svenssonjoel/FMRC/README.md

# FMRC (Work in progress)
Four Motor Robot Controller.

## General videos

[FMRC: UART communication between NRF52 and STM32!](https://youtu.be/KaF7SMBezBs)

## Firmware

### STM32F4 
* Work in progress

### NRF52
* TODO Start

* PROGRAMMING NRF52 stlink:  openocd -f interface/stlink.cfg -f target/nrf52.cfg

telnet localhost 4444
 > reset 
 > program zephyr.hex verify 

# V1_0

## Hardware

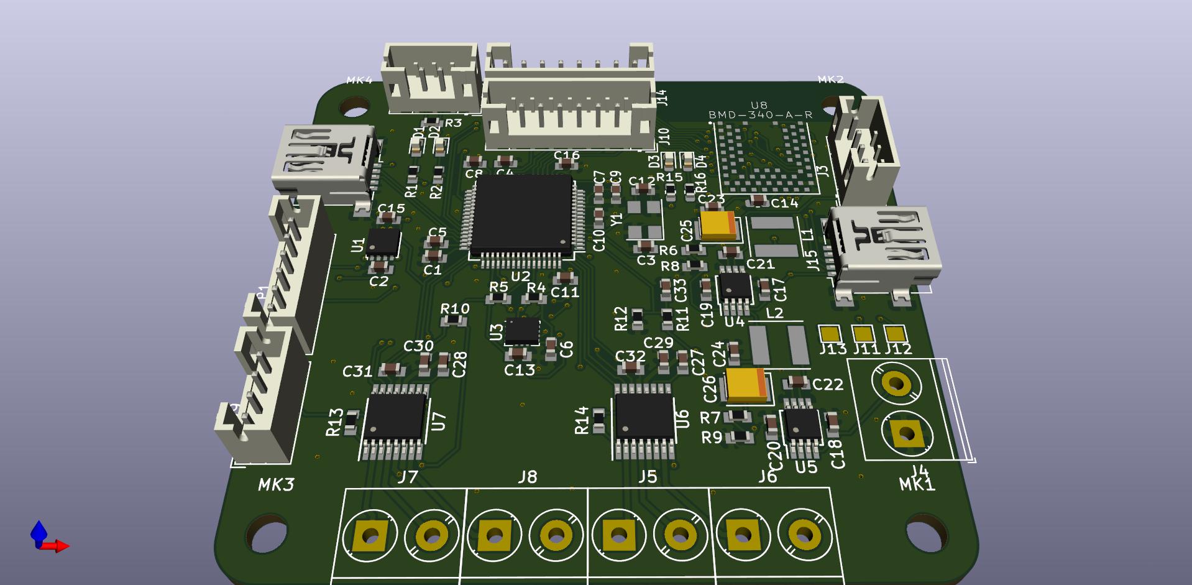
[picture p1: Pictures/FMRC_1_0.jpg]
Image of FMRC v1.0


Schematics of FMRC v1.0

whatgoeswhere FMRC v1.0

## PCBs arrived

Top view of FMRC v1.0

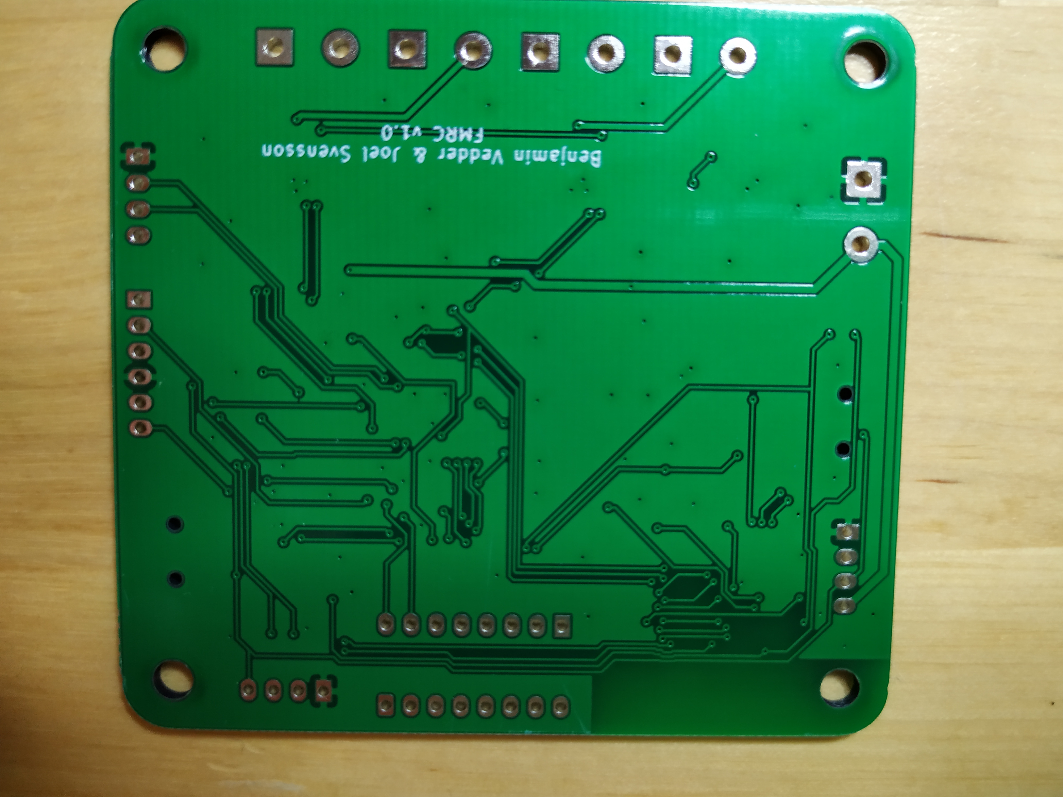
[picture p2: Pictures/bot.jpg]
Bottom view of FMRC v1.0


## Ready to start testing

Populated board FMRC v1.0

# V2_0

Work on version 2.0 is in progress. 

[FMRC V2 PART 14: First draft of completely routed PCB](https://youtu.be/DmLaImre3FM)

[FMRC V2 PART 13: More routing -- finishing off at the DRV8848 area](https://youtu.be/Vftj-5NWg6g )

[FMRC V2 PART 12: Starting to route in the DRV8848 area](https://youtu.be/RzzjTzkN7RY)

[FMRC V2 PART 11: More PCB routing](https://youtu.be/tmIGIp5ANTw)

[FMRC V2 PART 10: Started routing](https://youtu.be/_2mg14zOH1I)

[FMRC V2 PART 9: Tightening up the placement of components](https://youtu.be/uJEVWuKENiA)

[FMRC V2 PART 8: Roughly sorting components](https://youtu.be/DiCStZvnE-I)

[FMRC V2 PART 7: placing components focusing on the DC-DC area](https://youtu.be/_qIdTwvhaeo)

[FMRC V2 PART 6: Boot modes and Boot-loader that allows USB flashing](https://youtu.be/w9wKbaCBO-c)

[FMRC V2 PART 5: Adding an audio jack and doing some spice simulation in KiCAD](https://youtu.be/Df5hQqESk7Q)

[FMRC V2 PART 4: Servo outputs may be nice to have and finishing off in preparation for routing](https://youtu.be/peYSSjiu5AY)

[FMRC V2 PART 3: Out with the old, in with the new (and some confusion about pins with no net!)](https://youtu.be/iIYXo59sdyU)

[FMRC V2 PART 2B: Adding some caps and experimenting some more with kicad hierarchical labels](https://youtu.be/d1Me0BP48rM)

[FMRC V2 PART 2: Adding DRV8847 chips and trying out KICADs hiearchical labels](https://youtu.be/gP7LMV8jKK8)

[FMRC V2 PART 1: new 5V regulator that can do 3A](https://youtu.be/TqqdmnVX5Wo)
