svenssonjoel/FMRC/Pictures/whatgoeswhere.pdf

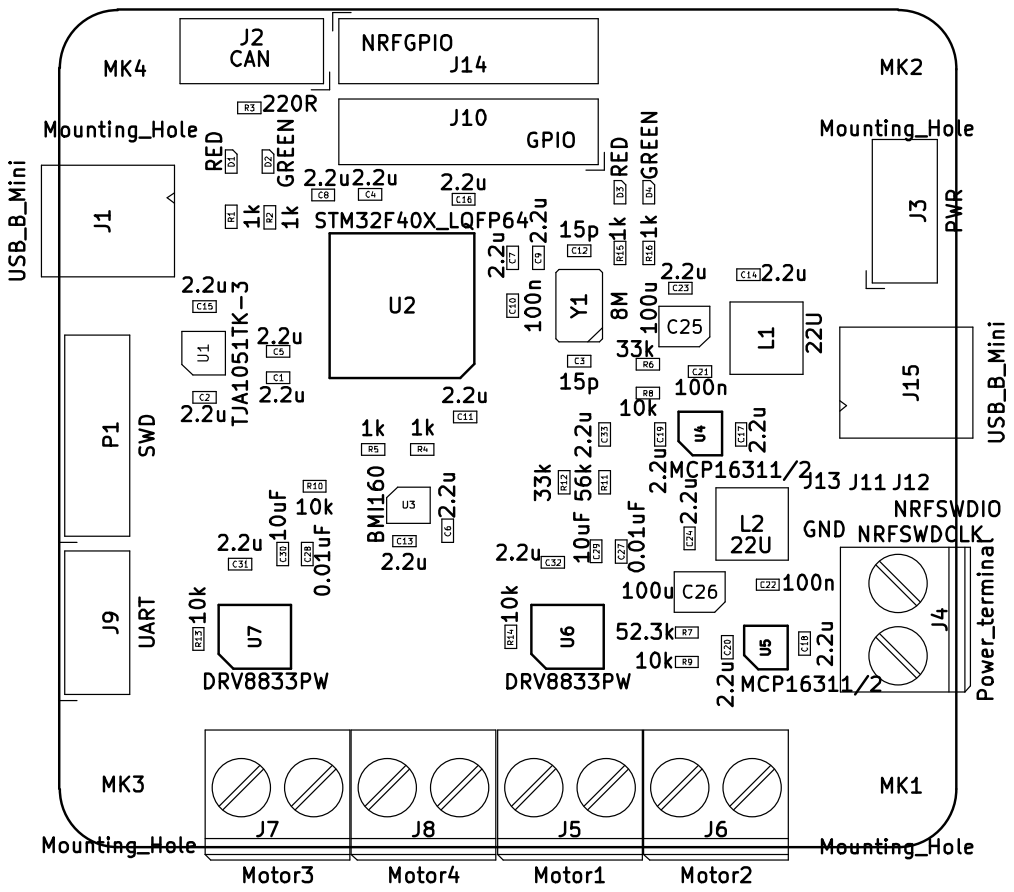
[picture p11: page 1]
