svenssonjoel/FMRC/hardware/v2_0/v2_0.kicad_pcb

## KiCad design hardware/v2_0/v2_0.kicad_pcb (2020-02-12)

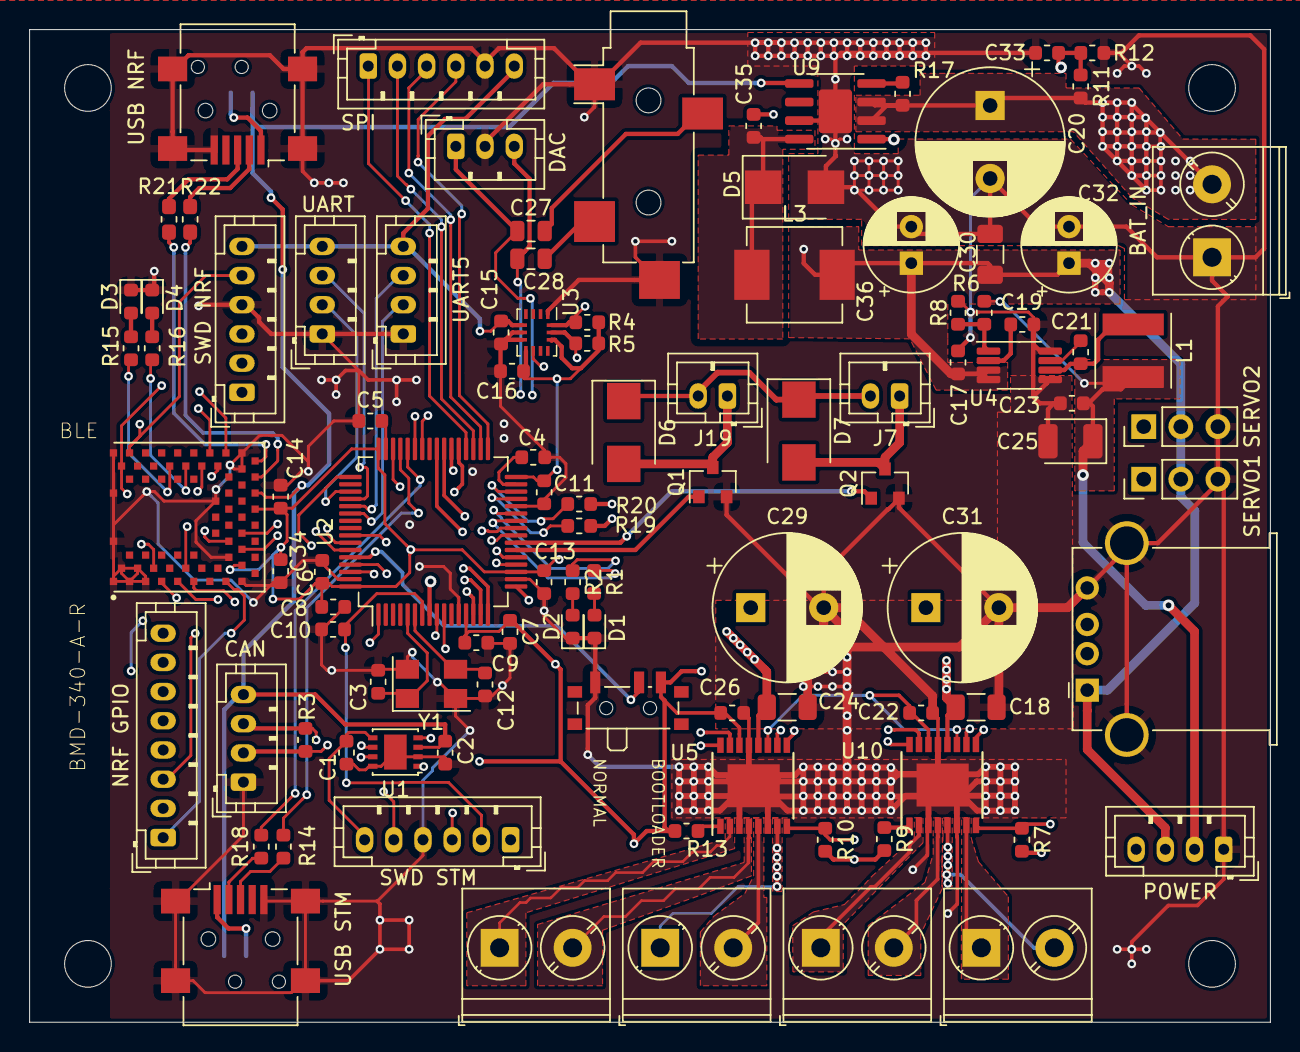
[picture p12: board v2_0.kicad_pcb from above]

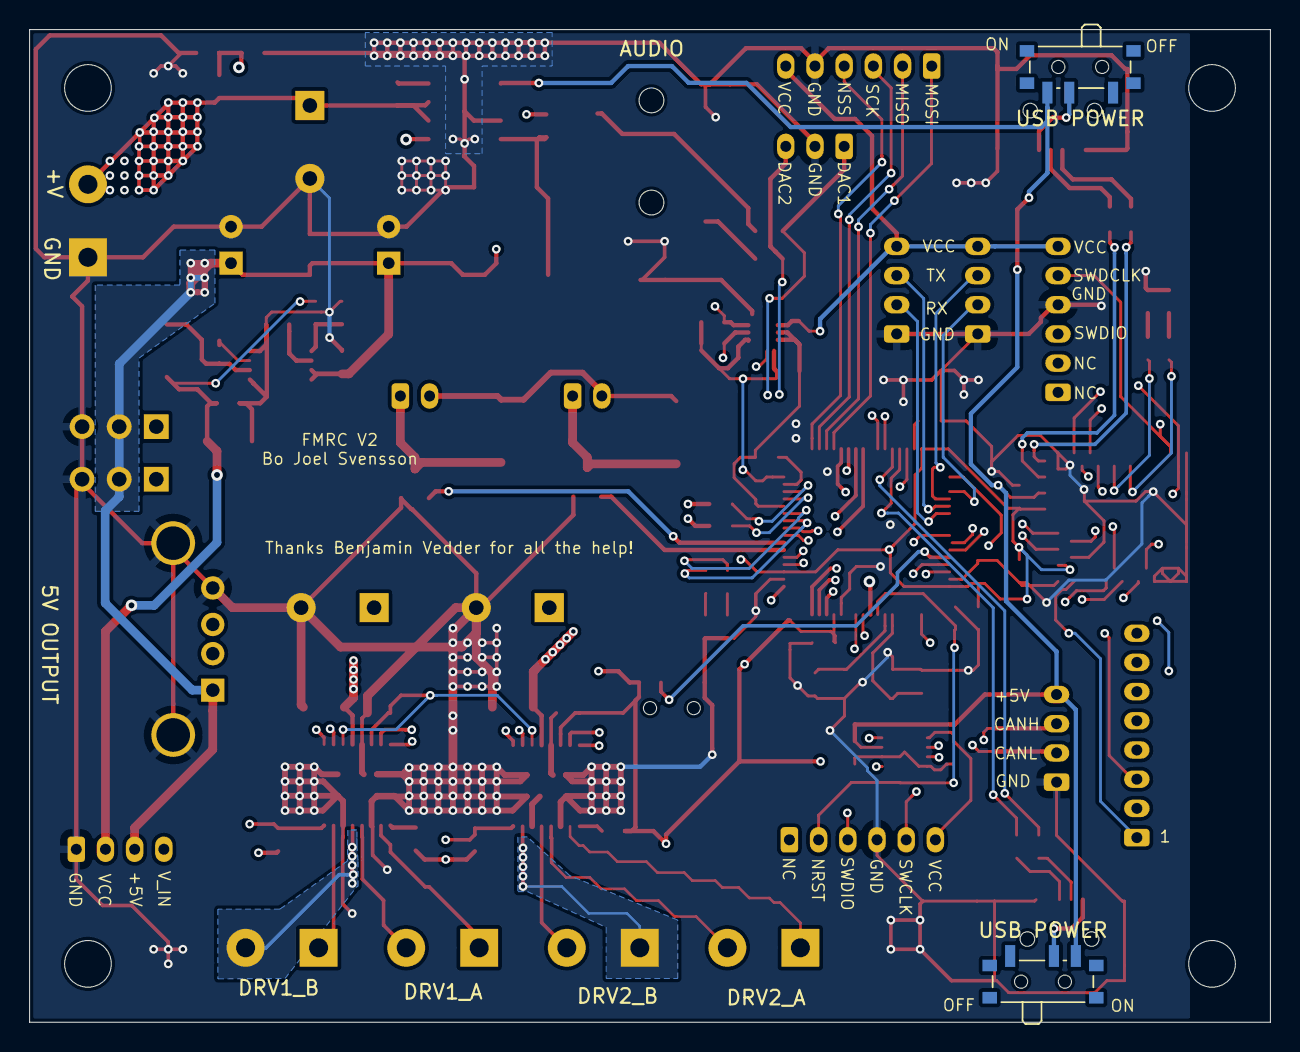
[picture p13: board v2_0.kicad_pcb from below]

Board: 4 copper layers, 85.0 x 68.0 mm, 107 parts (2 on the bottom side), 97 nets.

Parts:
5V OUTPUT: USB_A; USB_A_Stewart_SS-52100-001_Horizontal
AUDIO: AudioJack3_Ground; Jack_3.5mm_CUI_SJ-3524-SMT_Horizontal
BAT_IN: Power_terminal; TerminalBlock_Phoenix_PT-1,5-2-5.0-H_1x02_P5.00mm_Horizontal
BLE: BMD-340-A-R; RIGADO_BMD-340-A-R
C1, C2, C4, C5, C6, C7, C8, C9, C11, C13, C14, C15, C16, C17, C19, C22, C23, C26, C33, C34: 2.2u; C_0603_1608Metric
C3, C12: 15p; C_0603_1608Metric
C10, C21: 100n; C_0603_1608Metric
C18, C24, C30: 10uF; C_1206_3216Metric
C20, C29, C31: 100uF; CP_Radial_D10.0mm_P5.00mm
C25: 100u; CP_EIA-3528-12_Kemet-T
C27, C28: 10uF; C_0805_2012Metric
C32, C36: 47uF; CP_Radial_D6.3mm_P2.50mm
C35: 0.1uF; C_0603_1608Metric
CAN: CAN; JST_PH_B4B-PH-K_1x04_P2.00mm_Vertical
D1, D3: RED; LED_0603_1608Metric
D2, D4: GREEN; LED_0603_1608Metric
D5: SSB43L; D_SMB
D6, D7: D_Schottky; D_SMB
DAC: DAC; JST_PH_B3B-PH-K_1x03_P2.00mm_Vertical
DRV1_A, DRV2_A: DRV1_MTR1; TerminalBlock_Phoenix_PT-1,5-2-5.0-H_1x02_P5.00mm_Horizontal
DRV1_B, DRV2_B: DRV1_MTR2; TerminalBlock_Phoenix_PT-1,5-2-5.0-H_1x02_P5.00mm_Horizontal
J7: MTR2_CON; JST_PH_B2B-PH-K_1x02_P2.00mm_Vertical
J19: MTR1_CON; JST_PH_B2B-PH-K_1x02_P2.00mm_Vertical
L1: 22U; L_Taiyo-Yuden_MD-5050
L3: 4,7uH; L_Vishay_IHLP-2525
MK1, MK2, MK3, MK4: Mounting_Hole; MountingHole_3.2mm_M3
NRF GPIO: NRFGPIO; JST_PH_B8B-PH-K_1x08_P2.00mm_Vertical
POWER: PWR; JST_PH_B4B-PH-K_1x04_P2.00mm_Vertical
Q1, Q2: Q_NMOS_GSD; SOT-23
R1, R2, R4, R5, R15, R16: 1k; R_0603_1608Metric
R3, R19, R20: 220R; R_0603_1608Metric
R6: 33k; R_0603_1608Metric
R7, R8, R9, R10, R13: 10k; R_0603_1608Metric
R11: 56k; R_0603_1608Metric
R12: 12k; R_0603_1608Metric
R14, R18: 22R; R_0603_1608Metric
R17: 100k; R_0603_1608Metric
R21, R22: 22R; R_0603_1608Metric_Pad1.05x0.95mm_HandSolder
SERVO1: SERV1; PinHeader_1x03_P2.54mm_Vertical
SERVO2: SERV2; PinHeader_1x03_P2.54mm_Vertical
SPI: SPI; JST_PH_B6B-PH-K_1x06_P2.00mm_Vertical
SW3: BOOT0; SW_SPDT_PCM12
SWD NRF: NRFSWD; JST_PH_B6B-PH-K_1x06_P2.00mm_Vertical
SWD STM: SWD; JST_PH_B6B-PH-K_1x06_P2.00mm_Vertical
U1: TJA1051TK-3; DFN-8-1EP_3x3mm_P0.65mm_EP1.55x2.4mm
U2: STM32F40X_LQFP64; LQFP-64_10x10mm_P0.5mm
U3: BMI160; Bosch_LGA-14_3x2.5mm_P0.5mm
U4: MCP16311/2; MSOP-8_3x3mm_P0.65mm
U5, U10: DRV8848; TSSOP-16-1EP_4.4x5mm_P0.65mm
U9: ADP2303ARDZ-5.0; SOIC-8-1EP_3.9x4.9mm_P1.27mm_EP2.29x3mm
UART: USART3_UART4; JST_PH_B4B-PH-K_1x04_P2.00mm_Vertical
UART5: UART5; JST_PH_B4B-PH-K_1x04_P2.00mm_Vertical
USB NRF: USB_B_Mini; USB_Mini-B_Lumberg_2486_01_Horizontal
USB POWER: NRF_USB_POWER; SW_SPDT_PCM12
USB POWER#2: MCU_USB_POWER; SW_SPDT_PCM12
USB STM: USB_B_Mini; USB_Mini-B_Lumberg_2486_01_Horizontal
Y1: 8M; Crystal_SMD_5032-4Pin_5.0x3.2mm

Connections:
+5V: 5V OUTPUT.1, BLE.66, C2.1, C17.1, C30.1, C32.1, C36.1, CAN.4, L3.2, POWER.3, SERVO1.2, SERVO2.2, U1.3, U4.3, U4.4, U9.5, USB POWER.3, USB POWER#2.3
/DRV1_A1: U2.14, U10.16
/DRV1_A2: U2.15, U10.15
/DRV1_B1: U2.16, U10.9
/DRV1_B2: U2.17, U10.10
/DRV1_NFAULT: R7.1, U2.24, U10.8
/DRV2_A1: U2.37, U5.16
/DRV2_A2: U2.38, U5.15
/DRV2_B1: U2.39, U5.9
/DRV2_B2: U2.40, U5.10
/MTR1_PWM: Q1.1, U2.22
/MTR2_PWM: Q2.1, U2.23
/NFAULT_DRV2: R10.1, U2.25, U5.8
/base_sheet/BOOT0: SW3.2, U2.60
/base_sheet/SERV1: R19.1, U2.29
/base_sheet/SERV2: R20.1, U2.30
/base_sheet/SPI2_MISO: SPI.2, U2.35
/base_sheet/SPI2_MOSI: SPI.1, U2.36
/base_sheet/SPI2_NSS: SPI.4, U2.33
/base_sheet/SPI2_SCK: SPI.3, U2.34
/base_sheet/UART5_RX: U2.54, UART5.2
/base_sheet/UART5_TX: U2.53, UART5.3
CANH: CAN.3, R3.2, U1.7
CANL: CAN.2, R3.1, U1.6
CAN_RX: U1.4, U2.61
CAN_TX: U1.1, U2.62
GND: 5V OUTPUT.4, 5V OUTPUT.5, AUDIO.G, AUDIO.S, BAT_IN.1, BLE.1, BLE.2, BLE.3, BLE.4, BLE.5, BLE.16, BLE.18, BLE.29, BLE.30, BLE.45, BLE.46, BLE.47, BLE.55, C1.2, C2.2, C3.1, C4.1, C5.1, C6.2, C7.2, C8.2, C9.2, C10.2, C11.2, C12.1, C13.2, C14.2, C15.2, C16.2, C17.2, C18.1, C19.2, C20.2, C22.2, C23.2, C24.1, C25.2, C26.2, C29.2, C30.2, C31.2, C32.2, C33.1, C34.2, C36.2, CAN.1, D1.1, D2.1, D3.1, D4.1, D5.2, DAC.2, POWER.1, Q1.2, Q2.2, R8.1, R12.2, SERVO1.3, SERVO2.3, SPI.5, SW3.1, SWD NRF.4, SWD STM.4, U1.2, U1.8, U1.9, U2.12, U2.18, U2.28, U2.63, U3.1, U3.6, U3.7, U4.5, U4.8, U5.3, U5.6, U5.13, U5.17, U9.7, U9.9, U10.3, U10.6, U10.13, U10.17, UART.1, UART5.1, USB NRF.5, USB NRF.6, USB STM.5, USB STM.6, Y1.2, Y1.4
IMU_INT2: BLE.11, U2.57, U3.9
NRFGPIO1: BLE.15, NRF GPIO.1
NRFGPIO2: BLE.19, NRF GPIO.2
NRFGPIO3: BLE.20, NRF GPIO.3
NRFGPIO4: BLE.21, NRF GPIO.4
NRFGPIO5: BLE.31, NRF GPIO.5
NRFGPIO6: BLE.32, NRF GPIO.6
NRFGPIO7: BLE.33, NRF GPIO.7
NRFGPIO8: BLE.34, NRF GPIO.8
NRFRX: BLE.7, U2.42
NRFSWDCLK: BLE.43, SWD NRF.5, U2.10
NRFSWDIO: BLE.44, SWD NRF.3, U2.9
NRFTX: BLE.6, U2.43
NRFUSBD+: BLE.68, R21.2
NRFUSBD-: BLE.67, R22.2
NRST: C10.1, SWD STM.2, U2.7
unnamed: C3.2, U2.5, Y1.1
unnamed: C4.2, U2.31
unnamed: C5.2, U2.47
unnamed: C12.2, U2.6, Y1.3
unnamed: C19.1, U4.2
unnamed: C21.1, U4.7
unnamed: C21.2, L1.1, U4.6
unnamed: C27.1, DAC.1, U2.20
unnamed: AUDIO.R, C27.2
unnamed: C28.1, DAC.3, U2.21
unnamed: AUDIO.T, C28.2
unnamed: C35.1, U9.1
unnamed: C35.2, D5.1, L3.1, U9.8
unnamed: D1.2, R1.2
unnamed: D2.2, R2.2
unnamed: D3.2, R15.2
unnamed: D4.2, R16.2
unnamed: D6.2, J19.1, Q1.3
unnamed: D7.2, J7.1, Q2.3
unnamed: USB POWER#2.2, USB STM.1
unnamed: R18.1, USB STM.2
unnamed: R14.1, USB STM.3
unnamed: DRV1_A.1, U10.2
unnamed: DRV1_A.2, U10.4
unnamed: DRV1_B.1, U10.7
unnamed: DRV1_B.2, U10.5
unnamed: DRV2_A.1, U5.2
unnamed: DRV2_A.2, U5.4
unnamed: R19.2, SERVO1.1
unnamed: R20.2, SERVO2.1
unnamed: USB NRF.1, USB POWER.2
unnamed: R22.1, USB NRF.2
unnamed: R21.1, USB NRF.3
unnamed: DRV2_B.1, U5.7
unnamed: DRV2_B.2, U5.5
unnamed: R1.1, U2.26
unnamed: R2.1, U2.27
unnamed: R6.1, R8.2, U4.1
unnamed: R9.1, U10.1
unnamed: R13.1, U5.1
unnamed: BLE.38, R15.1
unnamed: BLE.36, R16.1
unnamed: R17.2, U9.4
SCL: BLE.10, R5.1, U2.58, U3.13
SDA: BLE.9, R4.1, U2.59, U3.14
SWCLK: SWD STM.5, U2.49
SWDIO: SWD STM.3, U2.46
UART_RXD: U2.51, UART.2
UART_TXD: U2.52, UART.3
USB_DM: R18.2, U2.44
USB_DP: R14.2, U2.45
VCC: BLE.17, BLE.65, C1.1, C6.1, C7.1, C8.1, C9.1, C11.1, C13.1, C14.1, C15.1, C16.1, C22.1, C23.1, C25.1, C26.1, C34.1, L1.2, POWER.2, R4.2, R5.2, R6.2, R7.2, R9.2, R10.2, R13.2, SPI.6, SW3.3, SWD NRF.6, SWD STM.6, U1.5, U2.1, U2.13, U2.19, U2.32, U2.48, U2.64, U3.5, U3.8, U3.12, U5.11, U5.14, U10.11, U10.14, UART.4, UART5.4
V_IN: BAT_IN.2, C18.2, C20.1, C24.2, C29.1, C31.1, D6.1, D7.1, J7.2, J19.2, POWER.4, R11.2, R17.1, U5.12, U9.2, U9.3, U10.12
V_METER: C33.2, R11.1, R12.1, U2.8
