svenssonjoel/FMRC/hardware/v1_0/robot_pcb0.kicad_pcb

## KiCad design hardware/v1_0/robot_pcb0.kicad_pcb (2019-06-18, an earlier design)

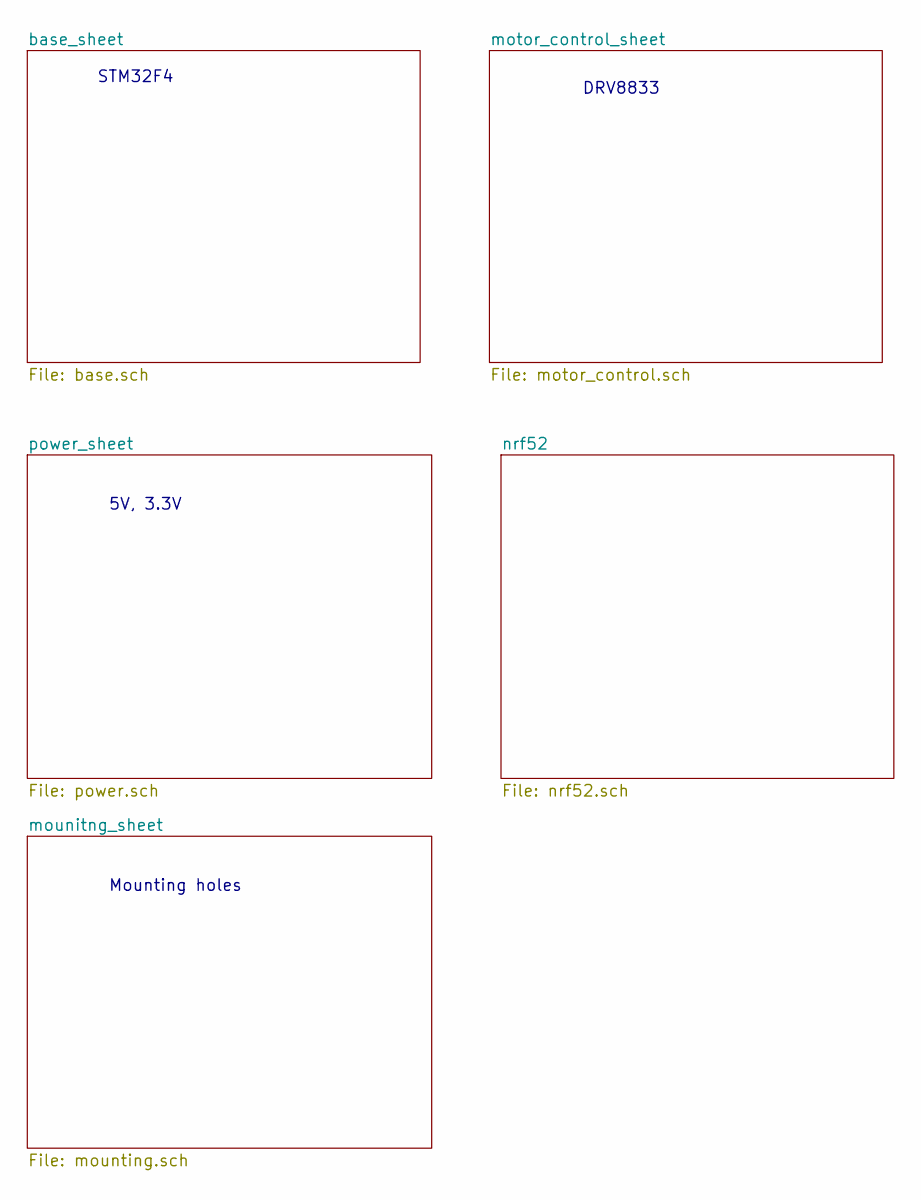
[picture p14: schematic robot_pcb0.sch, Four DC-Motor Controller]

Notes on the sheet:
STM32F4
5V, 3.3V
Mounting holes
DRV8833

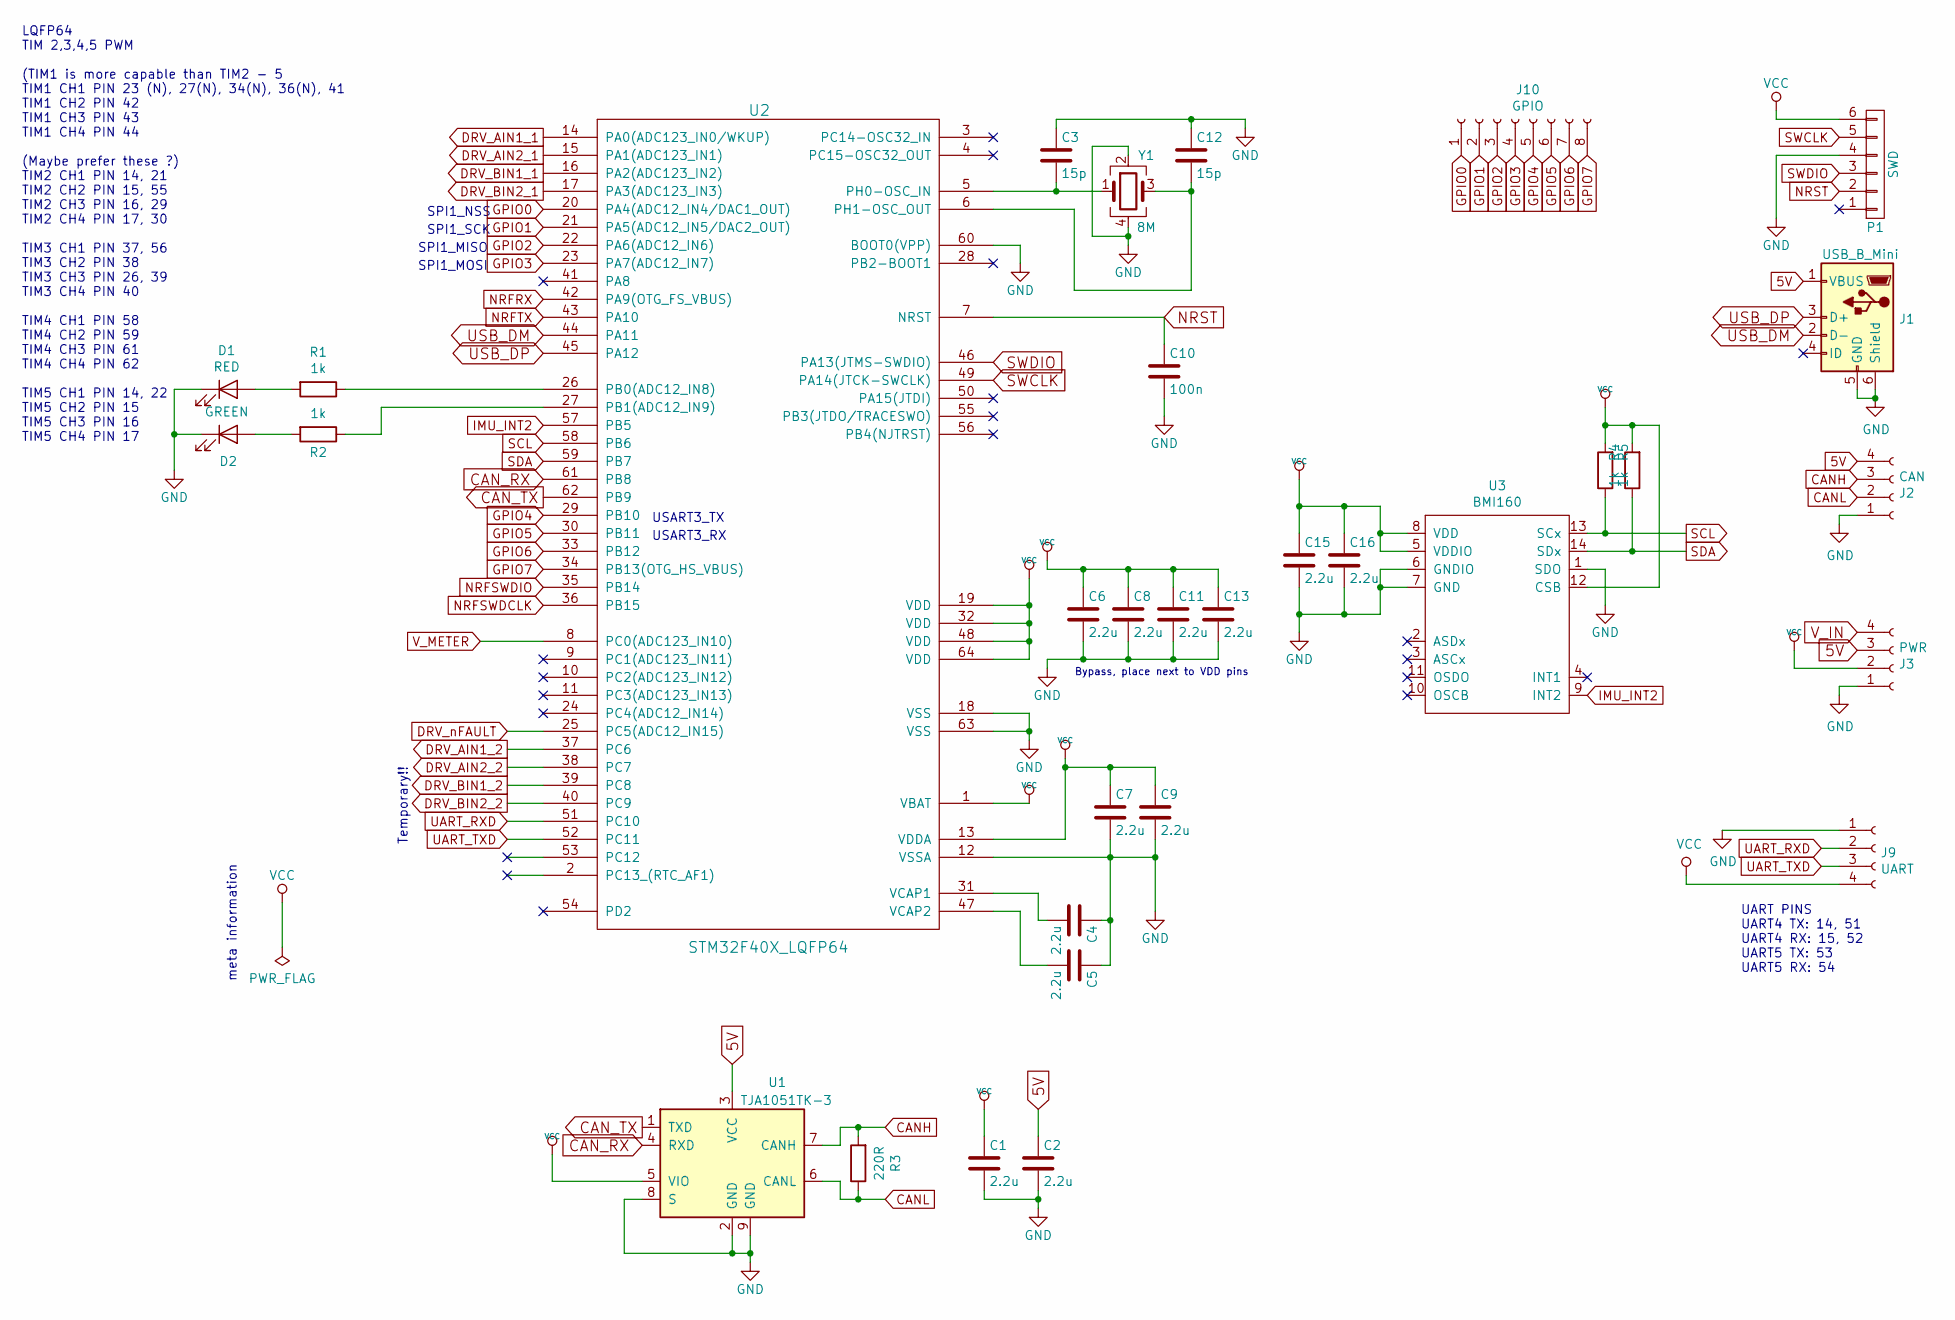
[picture p15: schematic base.sch]

Parts:
C1, C2, C4, C5, C6, C7, C8, C9, C11, C13, C15, C16: 2.2u; C_0603_1608Metric
C3, C12: 15p; C_0603_1608Metric
C10: 100n; C_0603_1608Metric
D1: RED; LED_0603_1608Metric
D2: GREEN; LED_0603_1608Metric
J1: USB_B_Mini; USB_Mini-B_Lumberg_2486_01_Horizontal
J2: CAN; JST_PH_B4B-PH-K_1x04_P2.00mm_Vertical
J3: PWR; JST_PH_B4B-PH-K_1x04_P2.00mm_Vertical
J9: UART; JST_PH_B4B-PH-K_1x04_P2.00mm_Vertical
J10: GPIO; JST_PH_B8B-PH-K_1x08_P2.00mm_Vertical
P1: SWD; JST_PH_B6B-PH-K_1x06_P2.00mm_Vertical
R1, R2, R4, R5: 1k; R_0603_1608Metric
R3: 220R; R_0603_1608Metric
U1: TJA1051TK-3; DFN-8-1EP_3x3mm_P0.65mm_EP1.55x2.4mm
U2: STM32F40X_LQFP64; LQFP-64_10x10mm_P0.5mm
U3: BMI160; Bosch_LGA-14_3x2.5mm_P0.5mm
Y1: 8M; Crystal_SMD_5032-4Pin_5.0x3.2mm

Connections:
5V: C2.1, J1.1 (VBUS), J2.4, J3.3, U1.3 (VCC); also elsewhere on the board
CANH: J2.3, R3.2, U1.7 (CANH)
CANL: J2.2, R3.1, U1.6 (CANL)
CAN_RX: U1.4 (RXD), U2.61 (PB8)
CAN_TX: U1.1 (TXD), U2.62 (PB9)
DRV_AIN1_1: U2.14 (PA0(ADC123_IN0/WKUP)); also elsewhere on the board
DRV_AIN1_2: U2.37 (PC6); also elsewhere on the board
DRV_AIN2_1: U2.15 (PA1(ADC123_IN1)); also elsewhere on the board
DRV_AIN2_2: U2.38 (PC7); also elsewhere on the board
DRV_BIN1_1: U2.16 (PA2(ADC123_IN2)); also elsewhere on the board
DRV_BIN1_2: U2.39 (PC8); also elsewhere on the board
DRV_BIN2_1: U2.17 (PA3(ADC123_IN3)); also elsewhere on the board
DRV_BIN2_2: U2.40 (PC9); also elsewhere on the board
DRV_nFAULT: U2.25 (PC5(ADC12_IN15)); also elsewhere on the board
GND: C1.2, C2.2, C3.1, C4.1, C5.1, C6.2, C7.2, C8.2, C9.2, C10.2, C11.2, C12.1, C13.2, C15.2, C16.2, D1.1 (K), D2.1 (K), J1.5 (GND), J1.6 (Shield), J2.1, J3.1, J9.1, P1.4, U1.2 (GND), U1.8 (S), U1.9 (GND), U2.12 (VSSA), U2.18 (VSS), U2.60 (BOOT0(VPP)), U2.63 (VSS), U3.1 (SDO), U3.6 (GNDIO), U3.7 (GND), Y1.2, Y1.4; also elsewhere on the board
GPIO0: J10.1, U2.20 (PA4(ADC12_IN4/DAC1_OUT))
GPIO1: J10.2, U2.21 (PA5(ADC12_IN5/DAC2_OUT))
GPIO2: J10.3, U2.22 (PA6(ADC12_IN6))
GPIO3: J10.4, U2.23 (PA7(ADC12_IN7))
GPIO4: J10.5, U2.29 (PB10)
GPIO5: J10.6, U2.30 (PB11)
GPIO6: J10.7, U2.33 (PB12)
GPIO7: J10.8, U2.34 (PB13(OTG_HS_VBUS))
IMU_INT2: U2.57 (PB5), U3.9 (INT2); also elsewhere on the board
NRFRX: U2.42 (PA9(OTG_FS_VBUS)); also elsewhere on the board
NRFSWDCLK: U2.36 (PB15); also elsewhere on the board
NRFSWDIO: U2.35 (PB14); also elsewhere on the board
NRFTX: U2.43 (PA10); also elsewhere on the board
NRST: C10.1, P1.2, U2.7 (NRST)
unnamed: C3.2, U2.5 (PH0-OSC_IN), Y1.1
unnamed: C4.2, U2.31 (VCAP1)
unnamed: C5.2, U2.47 (VCAP2)
unnamed: C12.2, U2.6 (PH1-OSC_OUT), Y1.3
unnamed: D1.2 (A), R1.2
unnamed: D2.2 (A), R2.2
unnamed: R1.1, U2.26 (PB0(ADC12_IN8))
unnamed: R2.1, U2.27 (PB1(ADC12_IN9))
SCL: R5.1, U2.58 (PB6), U3.13 (SCx); also elsewhere on the board
SDA: R4.1, U2.59 (PB7), U3.14 (SDx); also elsewhere on the board
SWCLK: P1.5, U2.49 (PA14(JTCK-SWCLK))
SWDIO: P1.3, U2.46 (PA13(JTMS-SWDIO))
UART_RXD: J9.2, U2.51 (PC10)
UART_TXD: J9.3, U2.52 (PC11)
USB_DM: J1.2 (D-), U2.44 (PA11)
USB_DP: J1.3 (D+), U2.45 (PA12)
VCC: C1.1, C6.1, C7.1, C8.1, C9.1, C11.1, C13.1, C15.1, C16.1, J3.2, J9.4, P1.6, R4.2, R5.2, U1.5 (VIO), U2.1 (VBAT), U2.13 (VDDA), U2.19 (VDD), U2.32 (VDD), U2.48 (VDD), U2.64 (VDD), U3.5 (VDDIO), U3.8 (VDD), U3.12 (CSB); also elsewhere on the board
V_IN: J3.4; also elsewhere on the board
V_METER: U2.8 (PC0(ADC123_IN10)); also elsewhere on the board

Notes on the sheet:
Bypass, place next to VDD pins
meta information
Temporary!!
UART PINS UART4 TX: 14, 51 UART4 RX: 15, 52 UART5 TX: 53 UART5 RX: 54
USART3_TX
USART3_RX
SPI1_NSS
SPI1_SCK
SPI1_MISO
SPI1_MOSI
LQFP64 TIM 2,3,4,5 PWM (TIM1 is more capable than TIM2 - 5 TIM1 CH1 PIN 23 (N), 27(N), 34(N), 36(N), 41 TIM1 CH2 PIN 42 TIM1 CH3 PIN 43 TIM1 CH4 PIN 44 (Maybe prefer these ?) TIM2 CH1 PIN 14, 21 TIM2 CH2 PIN 15, 55 TIM2 CH3 PIN 16, 29 TIM2 CH4 PIN 17, 30 TIM3 CH1 PIN 37, 56 TIM3 CH2 PIN 38 TIM3 CH3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

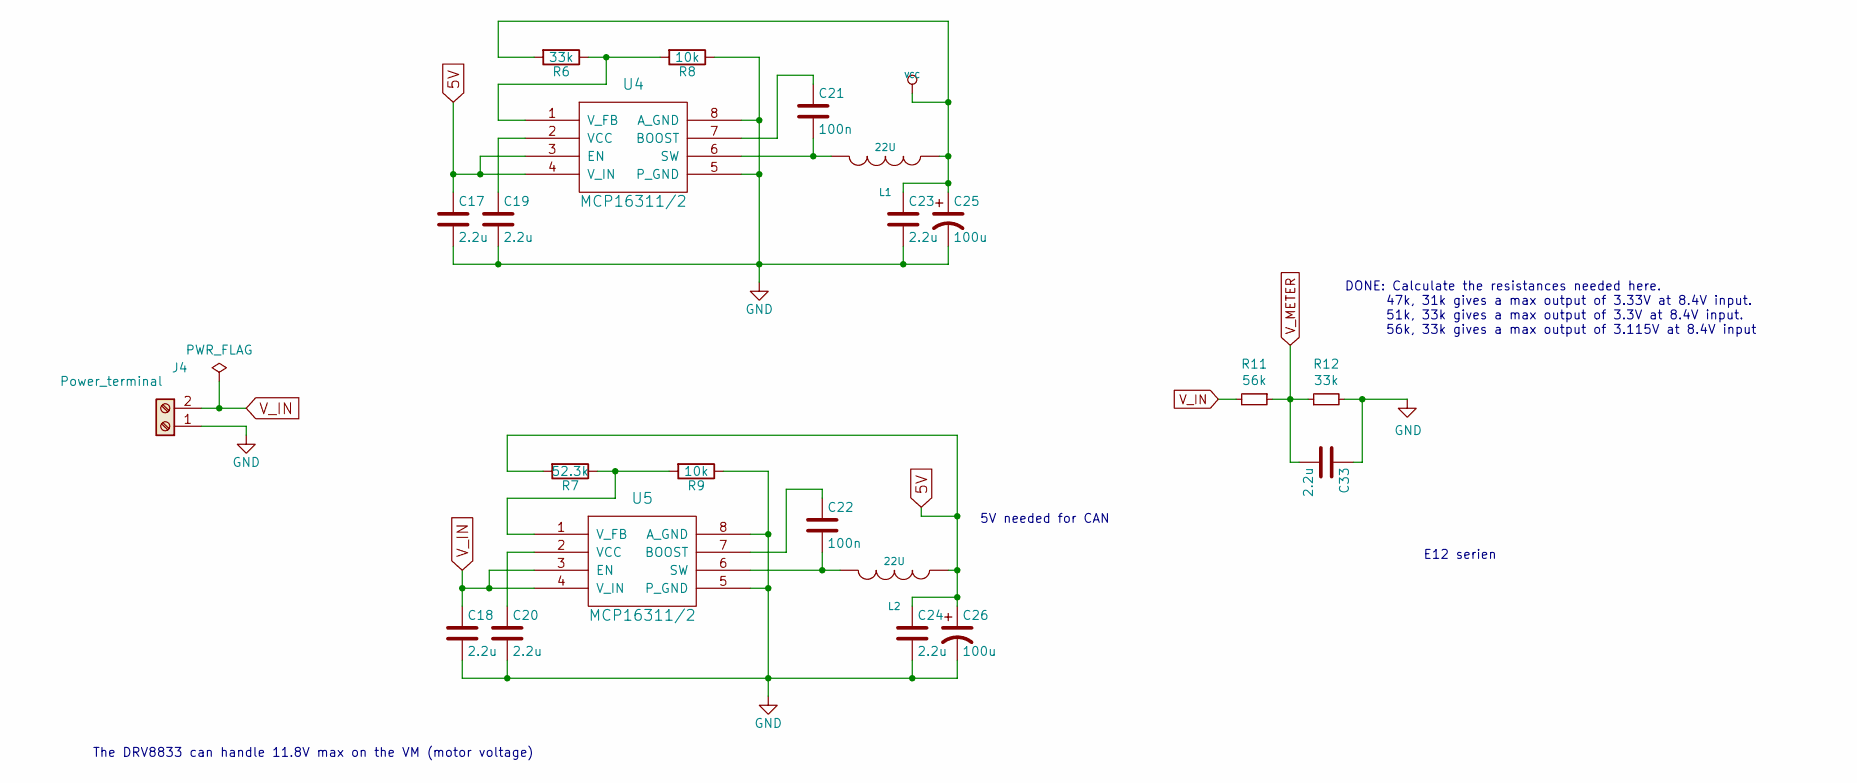
[picture p16: schematic power.sch]

Parts:
C17, C18, C19, C20, C23, C24, C33: 2.2u; C_0603_1608Metric
C21, C22: 100n; C_0603_1608Metric
C25, C26: 100u; CP_EIA-3528-12_Kemet-T
J4: Power_terminal; TerminalBlock_Phoenix_PT-1,5-2-5.0-H_1x02_P5.00mm_Horizontal
L1, L2: 22U; L_Taiyo-Yuden_MD-5050
R6, R12: 33k; R_0603_1608Metric
R7: 52.3k; R_0603_1608Metric
R8, R9: 10k; R_0603_1608Metric
R11: 56k; R_0603_1608Metric
U4, U5: MCP16311/2; MSOP-8_3x3mm_P0.65mm

Connections:
5V: C17.1, C24.1, C26.1, L2.1, R7.2, U4.3 (EN), U4.4 (V_IN); also elsewhere on the board
GND: C17.2, C18.2, C19.2, C20.2, C23.2, C24.2, C25.2, C26.2, C33.1, J4.1, R8.1, R9.1, R12.2, U4.5 (P_GND), U4.8 (A_GND), U5.5 (P_GND), U5.8 (A_GND); also elsewhere on the board
unnamed: C19.1, U4.2 (VCC)
unnamed: C20.1, U5.2 (VCC)
unnamed: C21.1, U4.7 (BOOST)
unnamed: C21.2, L1.2, U4.6 (SW)
unnamed: C22.1, U5.7 (BOOST)
unnamed: C22.2, L2.2, U5.6 (SW)
unnamed: R6.1, R8.2, U4.1 (V_FB)
unnamed: R7.1, R9.2, U5.1 (V_FB)
VCC: C23.1, C25.1, L1.1, R6.2; also elsewhere on the board
V_IN: C18.1, J4.2, R11.2, U5.3 (EN), U5.4 (V_IN); also elsewhere on the board
V_METER: C33.2, R11.1, R12.1; also elsewhere on the board

Notes on the sheet:
DONE: Calculate the resistances needed here. 47k, 31k gives a max output of 3.33V at 8.4V input. 51k, 33k gives a max output of 3.3V at 8.4V input. 56k, 33k gives a max output of 3.115V at 8.4V input
5V needed for CAN
E12 serien
The DRV8833 can handle 11.8V max on the VM (motor voltage)

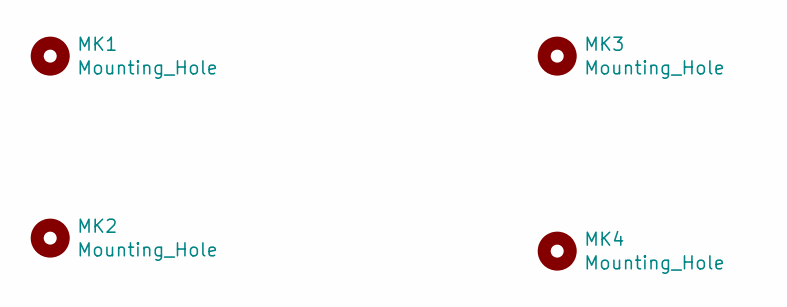
[picture p17: schematic mounting.sch]

Parts:
MK1, MK2, MK3, MK4: Mounting_Hole; MountingHole_3.2mm_M3

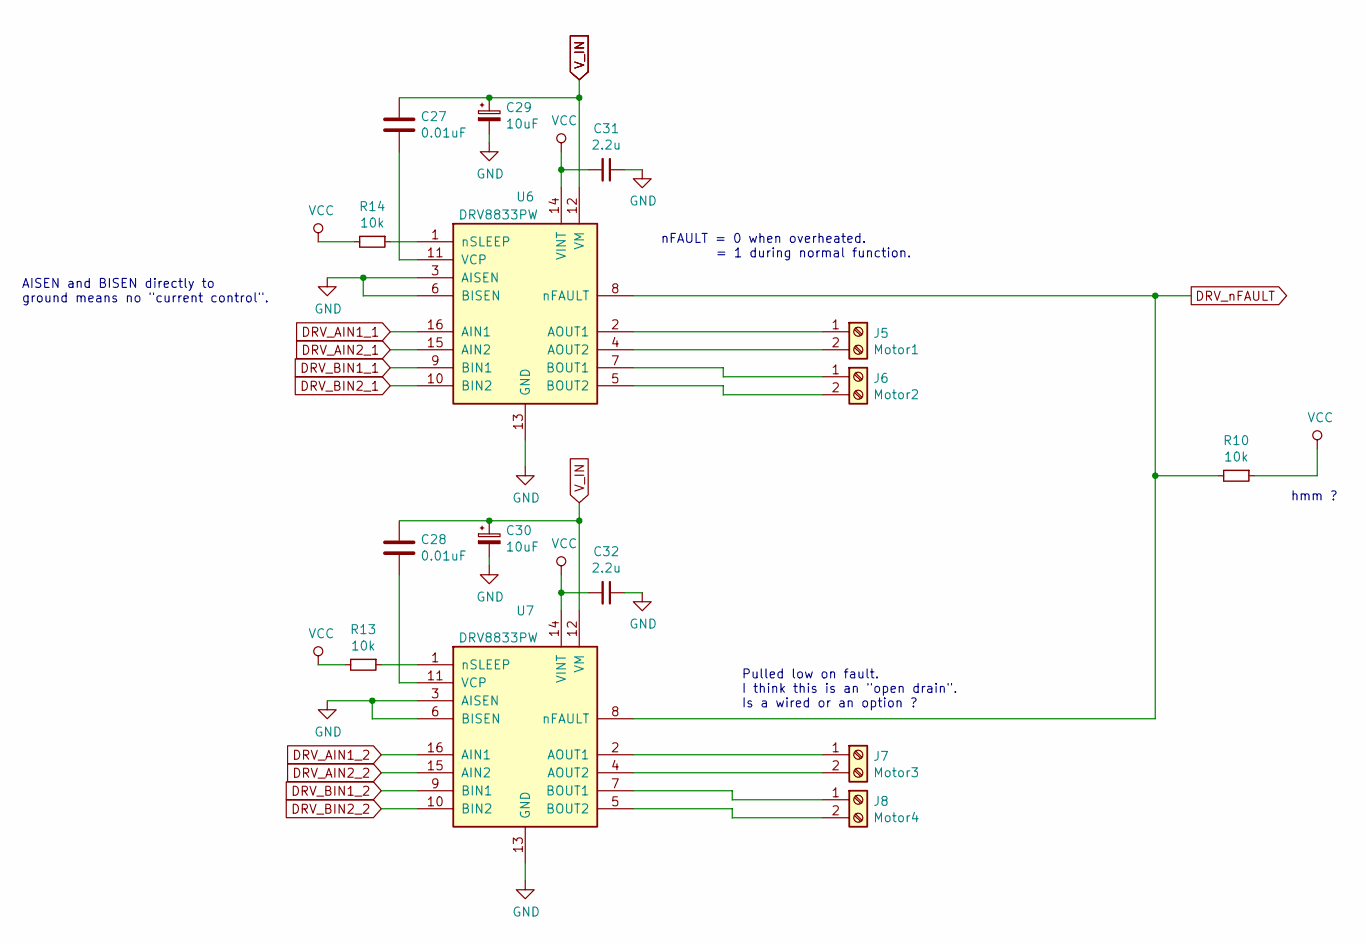
[picture p18: schematic motor_control.sch]

Parts:
C27, C28: 0.01uF; C_0603_1608Metric
C29, C30: 10uF; C_0603_1608Metric
C31, C32: 2.2u; C_0603_1608Metric
J5: Motor1; TerminalBlock_Phoenix_PT-1,5-2-5.0-H_1x02_P5.00mm_Horizontal
J6: Motor2; TerminalBlock_Phoenix_PT-1,5-2-5.0-H_1x02_P5.00mm_Horizontal
J7: Motor3; TerminalBlock_Phoenix_PT-1,5-2-5.0-H_1x02_P5.00mm_Horizontal
J8: Motor4; TerminalBlock_Phoenix_PT-1,5-2-5.0-H_1x02_P5.00mm_Horizontal
R10, R13, R14: 10k; R_0603_1608Metric
U6, U7: DRV8833PW; TSSOP-16_4.4x5mm_P0.65mm

Connections:
DRV_AIN1_1: U6.16 (AIN1); also elsewhere on the board
DRV_AIN1_2: U7.16 (AIN1); also elsewhere on the board
DRV_AIN2_1: U6.15 (AIN2); also elsewhere on the board
DRV_AIN2_2: U7.15 (AIN2); also elsewhere on the board
DRV_BIN1_1: U6.9 (BIN1); also elsewhere on the board
DRV_BIN1_2: U7.9 (BIN1); also elsewhere on the board
DRV_BIN2_1: U6.10 (BIN2); also elsewhere on the board
DRV_BIN2_2: U7.10 (BIN2); also elsewhere on the board
DRV_nFAULT: R10.2, U6.8 (nFAULT), U7.8 (nFAULT); also elsewhere on the board
GND: C29.2, C30.2, C31.1, C32.1, U6.3 (AISEN), U6.6 (BISEN), U6.13 (GND), U7.3 (AISEN), U7.6 (BISEN), U7.13 (GND); also elsewhere on the board
unnamed: C27.2, U6.11 (VCP)
unnamed: C28.2, U7.11 (VCP)
unnamed: J5.1, U6.2 (AOUT1)
unnamed: J5.2, U6.4 (AOUT2)
unnamed: J6.1, U6.7 (BOUT1)
unnamed: J6.2, U6.5 (BOUT2)
unnamed: J7.1, U7.2 (AOUT1)
unnamed: J7.2, U7.4 (AOUT2)
unnamed: J8.1, U7.7 (BOUT1)
unnamed: J8.2, U7.5 (BOUT2)
unnamed: R13.1, U7.1 (nSLEEP)
unnamed: R14.1, U6.1 (nSLEEP)
VCC: C31.2, C32.2, R10.1, R13.2, R14.2, U6.14 (VINT), U7.14 (VINT); also elsewhere on the board
V_IN: C27.1, C28.1, C29.1, C30.1, U6.12 (VM), U7.12 (VM); also elsewhere on the board

Notes on the sheet:
AISEN and BISEN directly to ground means no "current control".
nFAULT = 0 when overheated. = 1 during normal function.
Pulled low on fault. I think this is an "open drain". Is a wired or an option ?
hmm ?

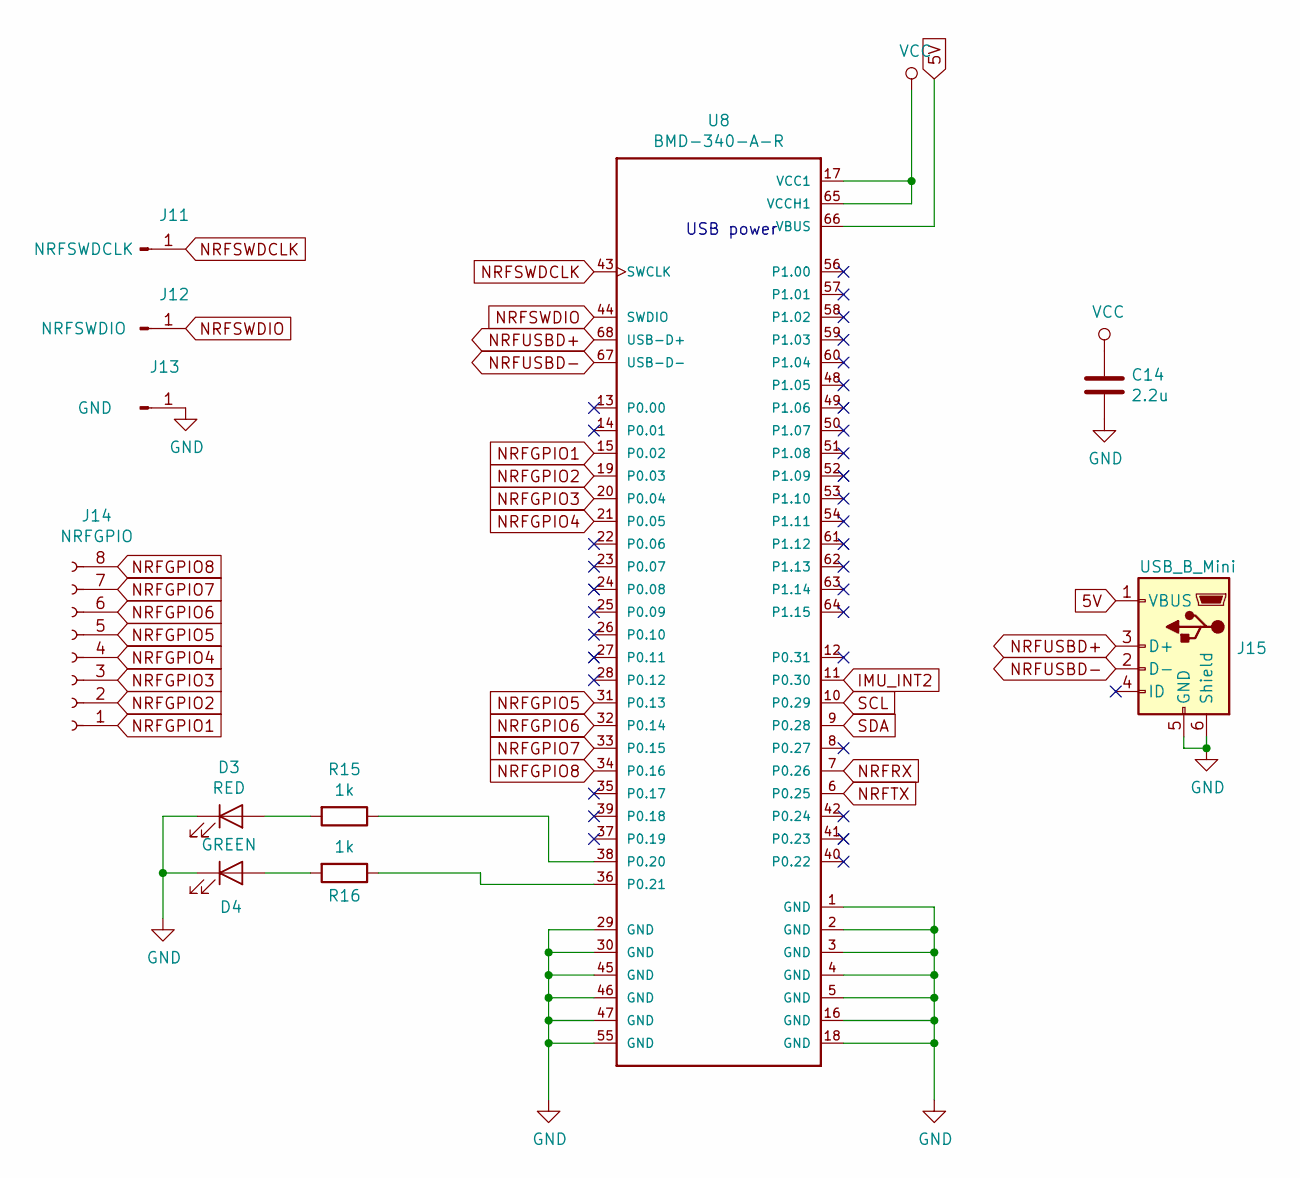
[picture p19: schematic nrf52.sch]

Parts:
C14: 2.2u; C_0603_1608Metric
D3: RED; LED_0603_1608Metric
D4: GREEN; LED_0603_1608Metric
J11: NRFSWDCLK; TestPoint_Pad_1.5x1.5mm
J12: NRFSWDIO; TestPoint_Pad_1.5x1.5mm
J13: GND; TestPoint_Pad_1.5x1.5mm
J14: NRFGPIO; JST_PH_B8B-PH-K_1x08_P2.00mm_Vertical
J15: USB_B_Mini; USB_Mini-B_Lumberg_2486_01_Horizontal
R15, R16: 1k; R_0603_1608Metric
U8: BMD-340-A-R; RIGADO_BMD-340-A-R

Connections:
5V: J15.1 (VBUS), U8.66 (VBUS); also elsewhere on the board
GND: C14.2, D3.1 (K), D4.1 (K), J13.1, J15.5 (GND), J15.6 (Shield), U8.1 (GND), U8.2 (GND), U8.3 (GND), U8.4 (GND), U8.5 (GND), U8.16 (GND), U8.18 (GND), U8.29 (GND), U8.30 (GND), U8.45 (GND), U8.46 (GND), U8.47 (GND), U8.55 (GND); also elsewhere on the board
IMU_INT2: U8.11 (P0.30); also elsewhere on the board
NRFGPIO1: J14.1, U8.15 (P0.02)
NRFGPIO2: J14.2, U8.19 (P0.03)
NRFGPIO3: J14.3, U8.20 (P0.04)
NRFGPIO4: J14.4, U8.21 (P0.05)
NRFGPIO5: J14.5, U8.31 (P0.13)
NRFGPIO6: J14.6, U8.32 (P0.14)
NRFGPIO7: J14.7, U8.33 (P0.15)
NRFGPIO8: J14.8, U8.34 (P0.16)
NRFRX: U8.7 (P0.26); also elsewhere on the board
NRFSWDCLK: J11.1, U8.43 (SWCLK); also elsewhere on the board
NRFSWDIO: J12.1, U8.44 (SWDIO); also elsewhere on the board
NRFTX: U8.6 (P0.25); also elsewhere on the board
NRFUSBD+: J15.3 (D+), U8.68 (USB-D+)
NRFUSBD-: J15.2 (D-), U8.67 (USB-D-)
unnamed: D3.2 (A), R15.2
unnamed: D4.2 (A), R16.2
unnamed: R15.1, U8.38 (P0.20)
unnamed: R16.1, U8.36 (P0.21)
SCL: U8.10 (P0.29); also elsewhere on the board
SDA: U8.9 (P0.28); also elsewhere on the board
VCC: C14.1, U8.17 (VCC1), U8.65 (VCCH1); also elsewhere on the board

Notes on the sheet:
USB power

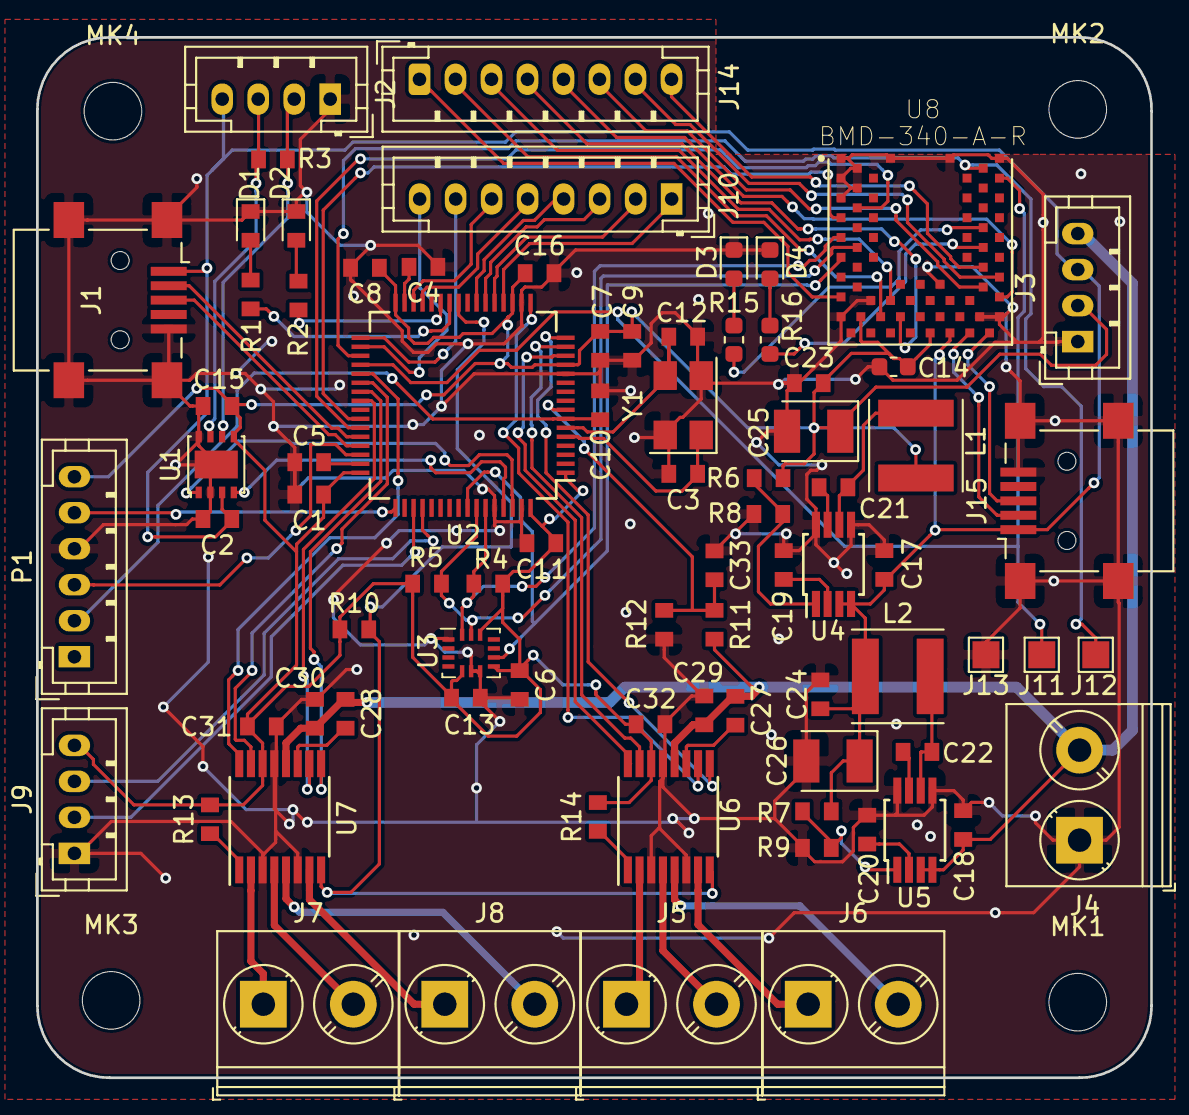
[picture p20: board robot_pcb0.kicad_pcb from above]

Board: 2 copper layers, 61.9 x 57.8 mm, 84 parts (0 on the bottom side), 82 nets.
