svenssonjoel/FMRC/(commit log)

2019-03-05 some routing
    [base.sch, motor_control.sch, mounting.sch, power.sch, robot_pcb0.kicad_pcb, robot_pcb0.sch]
2019-03-19 small amount of routing
    [robot_pcb0.kicad_pcb]
2019-05-29 routed and filled
    [base.sch, motor_control.sch, mounting.sch, power.sch, robot_pcb0.kicad_pcb, robot_pcb0.sch]
2019-05-29 added some extra vias and shortened a 5V path
    [robot_pcb0.kicad_pcb]
2019-06-01 rounded corners and some more vias between groundplanes
    [robot_pcb0.kicad_pcb]
2019-06-02 small tweaks
    [robot_pcb0.kicad_pcb]
2019-06-04 adding an nrf52
    [base.sch, motor_control.sch, mounting.sch, nrf52.sch, power.sch, robot_pcb0.kicad_pcb, robot_pcb0.sch]
2019-06-05 Routing done with nrf52
    [base.sch, nrf52.sch, robot_pcb0.kicad_pcb]
2019-06-12 added a pic and some tweaks
    [robot_pcb0.kicad_pcb]
2019-06-13 adding schematics as PDF
2019-06-18 tweaking comments layer to make finding whatgoeswhere easier
    [robot_pcb0.kicad_pcb]
2019-07-19 added image of populated board
2019-07-19 restructuring making room for firmware
    [base.sch, motor_control.sch, mounting.sch, nrf52.sch, power.sch, robot_pcb0.kicad_pcb, robot_pcb0.sch]
2019-07-22 Added initial fw code
    [STM32L4+.ods, stm_spc56ec74a256s_spc56ec74_minimodule_debug_jtag.cfg, stm_xpc560b64_minimodule_debug_jtag.cfg, stm_xpc560b_spc560d40_minimodule_debug_jtag.cfg, stm_xpc560p_minimodule_40mhz_debug_jtag.cfg, stm_xpc563m64_minimodule_debug_jtag.cfg, stm_xpc564a_spc564a70_minimodule_debug_jtag.cfg, stm_xpc56el_minimodule_lockstep_debug_jtag.cfg]
2019-07-28 attempting to talk to the drv8833 chips using PWM. No success yet
2019-07-29 small tweak, still freezes upon second call to pwmEnableChannel (for same channel)
2019-07-30 still hangs on call to pwmEnableChannel, but it seems to only do so when pwmEnableChannel is called within a callback passed to LispBM as an extension
    [stm32f407g.cfg]
2019-07-31 experimenting with the strange behaviour of pwmEnableChannel, with lots of help from ChibiOS forum The problem went away with increase of THD_WORKING_AREA_SIZE
    [main.c]
2019-08-12 moving led init / write to led.c/h
2019-08-12 moving drv8833 init function to motor_drv.c/h
2019-08-13 removing the shell code and instead starting the repl immediately in a separate thread.
2019-09-27 adding BMI160 driver from Bosch in preparation of future work
2019-09-27 preparing for i2c experiments
2019-09-28 experimenting with i2c and BMI160. I get absolutely no lifesigns from the bmi160
2019-09-29 IMU seems to work. the problem was hardware all along
    [main.c]
2019-10-06 Moving imu intialisation into a separate file
2019-10-30 Moving neato lidar control to a thread
2019-11-02 Experimenting with neato-lidar calibration. Now ttrying to target 300 RPM by doing binary search over the duty cycle
2019-11-12 added initial experiemtal nrf firmware and a Black Magic flashing attempts via STM32
2019-11-13 moving hw v 1.0 into folder in preparation for v 2.0 work
    [base.sch, motor_control.sch, mounting.sch, nrf52.sch, power.sch, robot_pcb0.kicad_pcb, robot_pcb0.sch]
2019-11-13 preparing for work on v2 of hardware
    [base.sch, motor_control.sch, mounting.sch, nrf52.sch, power.sch, v2_0.kicad_pcb, v2_0.sch]
2019-11-15 changes to regulator
    [power.sch]
2019-11-16 update symbol drv8847
    [motor_control.sch]
2019-11-17 updates and tweaks to FMRC v2
    [base.sch, motor_control.sch, power.sch, v2_0.sch]
2019-11-18 updates and improvements
    [base.sch, motor_control.sch, nrf52.sch, power.sch, v2_0.kicad_pcb, v2_0.sch]
2019-11-20 I hope it is time for routing soon
    [base.sch, motor_control.sch, nrf52.sch, v2_0.kicad_pcb, v2_0.sch]
2019-11-21 added switches to turn off usb power
    [base.sch, nrf52.sch]
2019-11-22 adding an audio jack!
    [base.sch, nrf52.sch, v2_0.kicad_pcb]
2019-11-24 uart comm between NRF52 and STM32
2019-11-25 switch that lets us select bootloader mode
    [base.sch, motor_control.sch, power.sch]
2019-11-26 Seems like using 2 instances of serial driver may be a problem in Chibios??
    [main.c, mainwindow.cpp, neato_lidar.c]
2019-11-27 added OrderNumbers for most components
    [base.sch, motor_control.sch, nrf52.sch, power.sch]
2019-11-28 use same kind of diode everywhere
    [motor_control.sch]
2019-11-28 experimenting with uart timeout
2019-11-28 tweaks, but this code is old and needs a merge with what is on the home computer
    [motor_control.sch]
2019-11-29 tweaks prepare for routing
    [motor_control.sch, power.sch, v2_0.kicad_pcb]
2019-11-29 fixed mistake in schematics
    [base.sch, v2_0.kicad_pcb]
2019-11-29 started routing
    [power.sch, v2_0.kicad_pcb]
2019-11-29 updated placement of components
    [base.sch, motor_control.sch, nrf52.sch, v2_0.kicad_pcb]
2019-11-30 routing some more
    [v2_0.kicad_pcb]
2019-12-02 routing some
    [v2_0.kicad_pcb]
2019-12-02 routing finished... at least first draft thereof
    [base.sch, v2_0.kicad_pcb]
